Kristtiya/KittyCaddy/Pictures/Mechanical.jpg

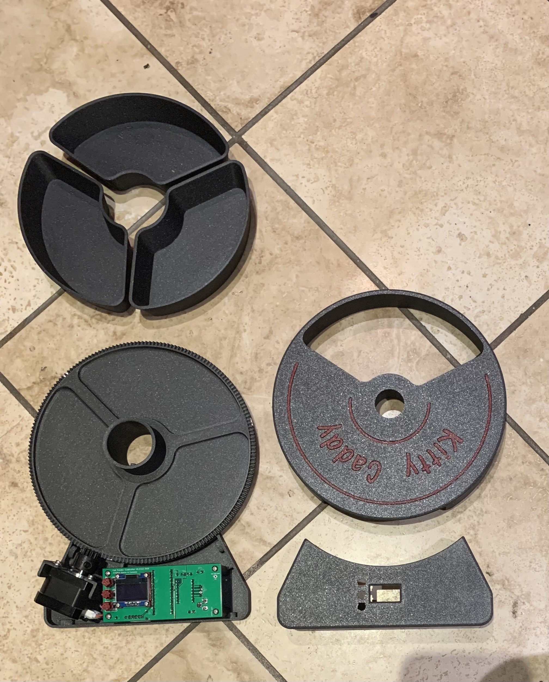
Pictures/Mechanical.jpg
