Kristtiya/KittyCaddy/Pictures/GUII2C.jpg

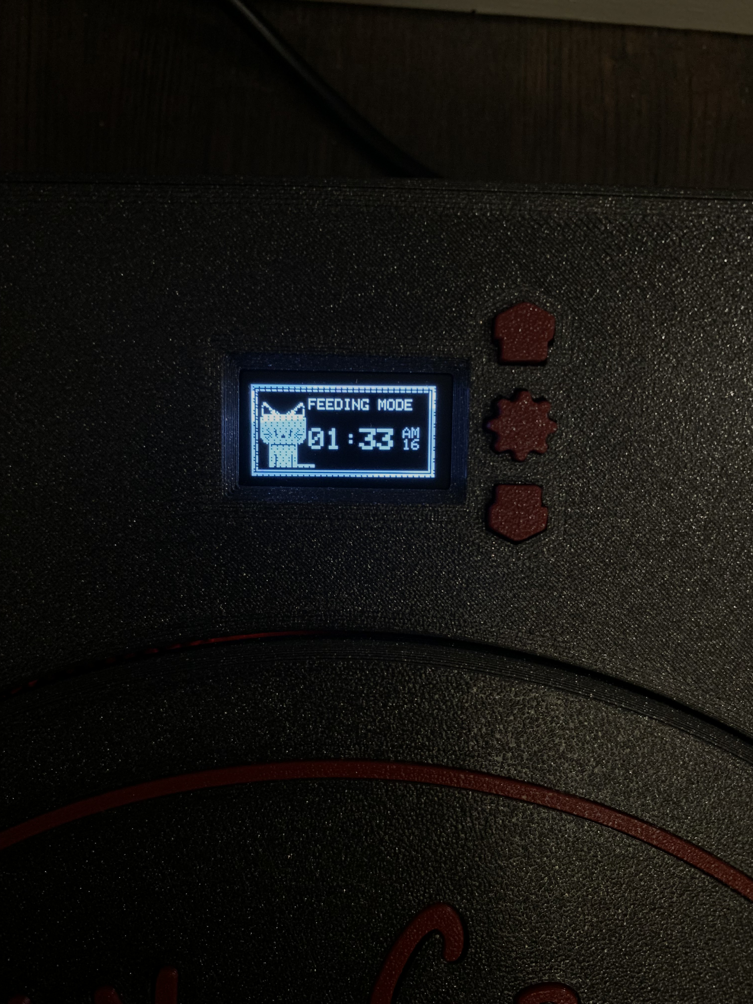
Pictures/GUII2C.jpg
