Kristtiya/KittyCaddy/Pictures/PCB Front.jpg

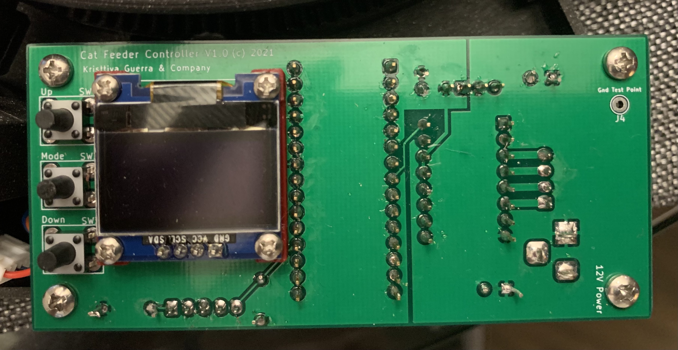
Pictures/PCB Front.jpg
