Kristtiya/KittyCaddy/Pictures/PCBwire.JPG

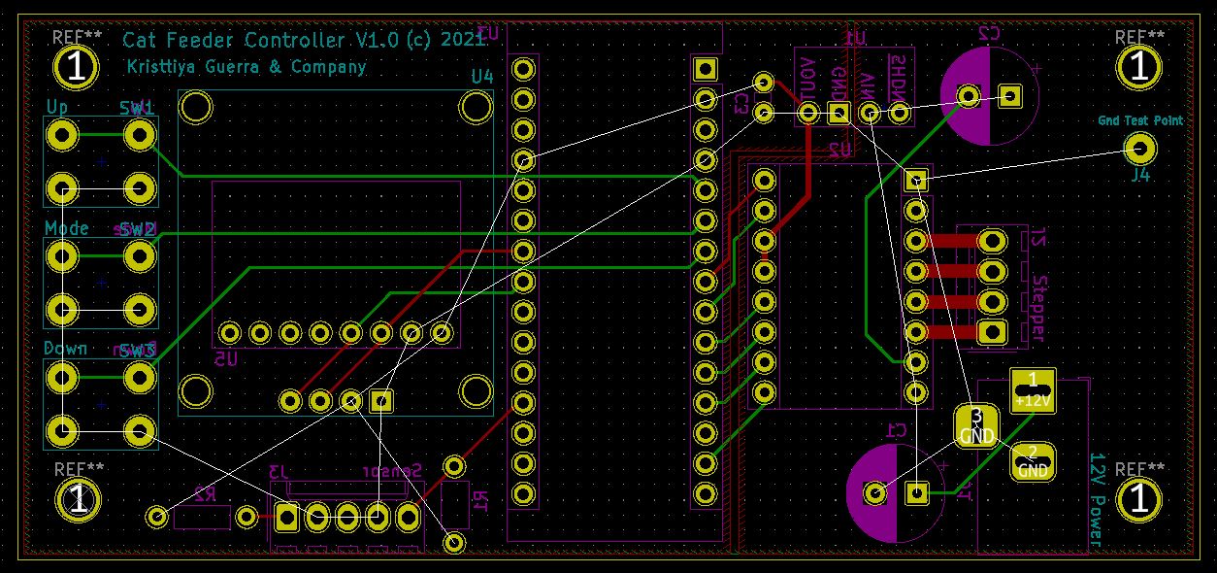
Pictures/PCBwire.JPG
