Kristtiya/KittyCaddy/Pictures/Schematic.JPG

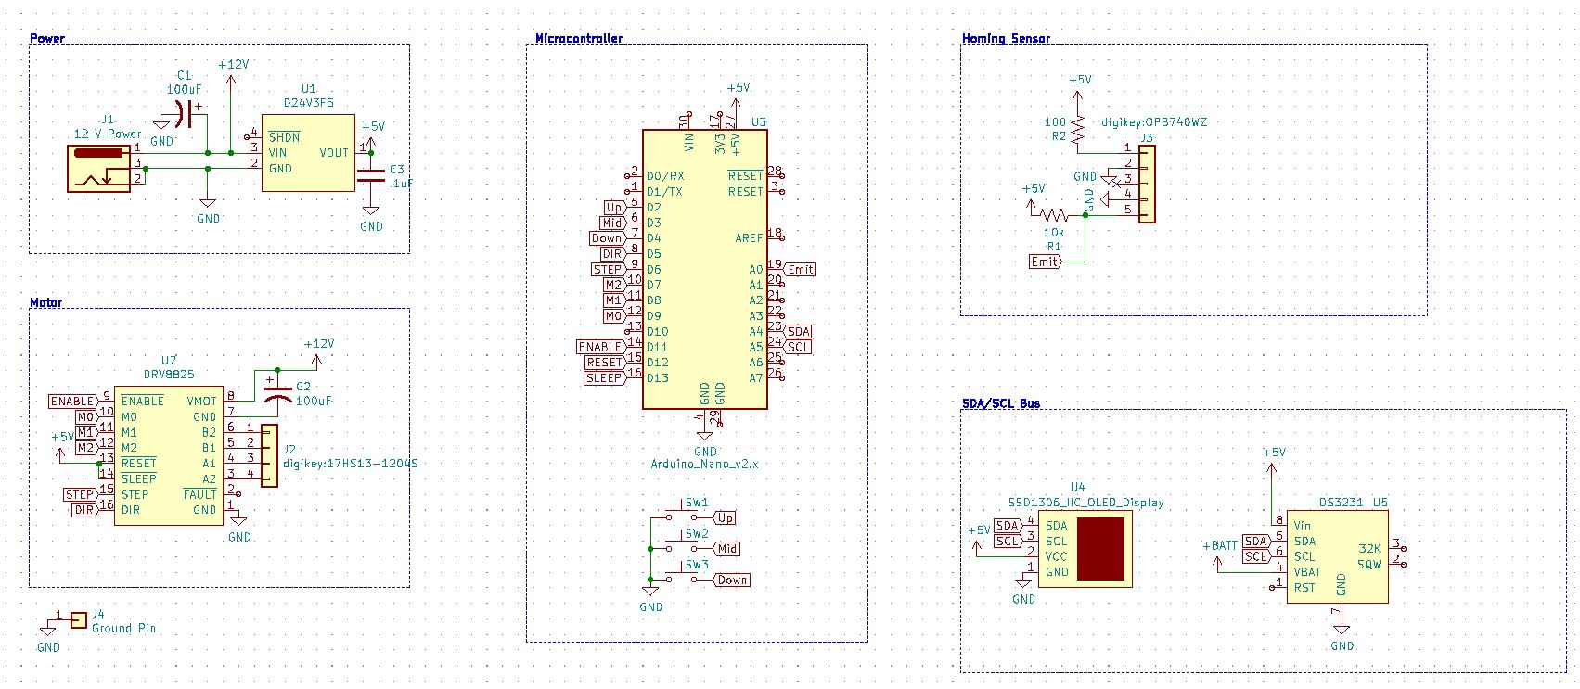
Pictures/Schematic.JPG
