Kristtiya/KittyCaddy/Schedule.xlsx

Sheet: Calendar
2021 | DECEMBER |  | MONDAY
CALENDAR YEAR | CALENDAR MONTH |  | FIRST DAY OF WEEK
44522 | 44523 | 44524 | 44525 | 44526 | 44527 | 44528
2021-11-29 | 2021-11-30 | 2021-12-01 | 2021-12-02 | 2021-12-03 | 2021-12-04 | 2021-12-05
2021-12-06 | 2021-12-07 | 2021-12-08 | 2021-12-09 | 2021-12-10 | 2021-12-11 | 2021-12-12
2021-12-13 | 2021-12-14 | 2021-12-15 | 2021-12-16 | 2021-12-17 | 2021-12-18 | 2021-12-19
2021-12-20 | 2021-12-21 | 2021-12-22 | 2021-12-23 | 2021-12-24 | 2021-12-25 | 2021-12-26
2021-12-27 | 2021-12-28 | 2021-12-29 | 2021-12-30 | 2021-12-31 | 2022-01-01 | 2022-01-02
2022-01-03 | 2022-01-04 | 2022-01-05 | 2022-01-06 | 2022-01-07 | 2022-01-08 | 2022-01-09

Sheet: October
2021 | OCTOBER |  | MONDAY
CALENDAR YEAR | CALENDAR MONTH |  | FIRST DAY OF WEEK
44522 | 44523 | 44524 | 44525 | 44526 | 44527 | 44528
2021-11-29 | 2021-11-30 | 2021-12-01 | 2021-12-02 | 2021-12-03 | 2021-12-04 | 2021-12-05
2021-12-06 | 2021-12-07 | 2021-12-08 | 2021-12-09 | 2021-12-10 | 2021-12-11 | 2021-12-12
2021-12-13 | 2021-12-14 | 2021-12-15 | 2021-12-16 | 2021-12-17 | 2021-12-18 | 2021-12-19
Finish Schematic + Footprint | Present work to Stan; Finish Footprints; Begin PCB | Work on PCB, Breadboard components | Complete PCB; begin testing components> Begin programming buttons and display since they lack external components. Goal:Get motor to rotate with buttons.
2021-12-20 | 2021-12-21 | 2021-12-22 | 2021-12-23 | 2021-12-24 | 2021-12-25 | 2021-12-26
Show breadboard and code. Show PCB and order | Goal:Connect clock to display and be able to display a time; Connect buttons to clock- toggle. Stretch goal>Select and edit time ; Continue working on understanding of motor
2021-12-27 | 2021-12-28 | 2021-12-29 | 2021-12-30 | 2021-12-31 | 2022-01-01 | 2022-01-02
Show Stan Testing Sequence; Plan out how to combine all features; Present Beepy? | Goal: Get motor to rotate with clock - 30 second interval;
2022-01-03 | 2022-01-04 | 2022-01-05 | 2022-01-06 | 2022-01-07 | 2022-01-08 | 2022-01-09

Sheet: November1
2021 | NOVEMBER |  | MONDAY
CALENDAR YEAR | CALENDAR MONTH |  | FIRST DAY OF WEEK
44522 | 44523 | 44524 | 44525 | 44526 | 44527 | 44528
2021-11-29 | 2021-11-30 | 2021-12-01 | 2021-12-02 | 2021-12-03 | 2021-12-04 | 2021-12-05
Show Stan coding progress; Present soldered PCB; Determing if necessary to make new PCB | Address PCB feedback; Continue working on Motor-clock code. Note errors and problems with code
2021-12-06 | 2021-12-07 | 2021-12-08 | 2021-12-09 | 2021-12-10 | 2021-12-11 | 2021-12-12
Present current feeder and show issues- address code problems on spot | Work on Motor-clock code. Mess around with UI.
2021-12-13 | 2021-12-14 | 2021-12-15 | 2021-12-16 | 2021-12-17 | 2021-12-18 | 2021-12-19
Present current feeder and show issues- address code problems on spot | Continue Polishing code for display; Address minor issues with cat feeder rotation; Det. Upgrade of certain components
2021-12-20 | 2021-12-21 | 2021-12-22 | 2021-12-23 | 2021-12-24 | 2021-12-25 | 2021-12-26
Show stan current feeder. Discuss upgrading certain components if neceassary | Continue Polishing code for display; Address minor issues with cat feeder rotation; Det. Upgrade of certain components
2021-12-27 | 2021-12-28 | 2021-12-29 | 2021-12-30 | 2021-12-31 | 2022-01-01 | 2022-01-02
Show stan current feeder. Discuss upgrading certain components if neceassary | Continue Polishing code for display; Address minor issues with cat feeder rotation; Det. Upgrade of certain components
2022-01-03 | 2022-01-04 | 2022-01-05 | 2022-01-06 | 2022-01-07 | 2022-01-08 | 2022-01-09

Sheet: December
2021 | DECEMBER |  | MONDAY
CALENDAR YEAR | CALENDAR MONTH |  | FIRST DAY OF WEEK
44522 | 44523 | 44524 | 44525 | 44526 | 44527 | 44528
2021-11-29 | 2021-11-30 | 2021-12-01 | 2021-12-02 | 2021-12-03 | 2021-12-04 | 2021-12-05
2021-12-06 | 2021-12-07 | 2021-12-08 | 2021-12-09 | 2021-12-10 | 2021-12-11 | 2021-12-12
2021-12-13 | 2021-12-14 | 2021-12-15 | 2021-12-16 | 2021-12-17 | 2021-12-18 | 2021-12-19
Present Final work + Portfolio + project documentaion
2021-12-20 | 2021-12-21 | 2021-12-22 | 2021-12-23 | 2021-12-24 | 2021-12-25 | 2021-12-26
2021-12-27 | 2021-12-28 | 2021-12-29 | 2021-12-30 | 2021-12-31 | 2022-01-01 | 2022-01-02
2022-01-03 | 2022-01-04 | 2022-01-05 | 2022-01-06 | 2022-01-07 | 2022-01-08 | 2022-01-09
