Kristtiya/KittyCaddy/KittyCaddy_KiCAD/Schematic.pdf

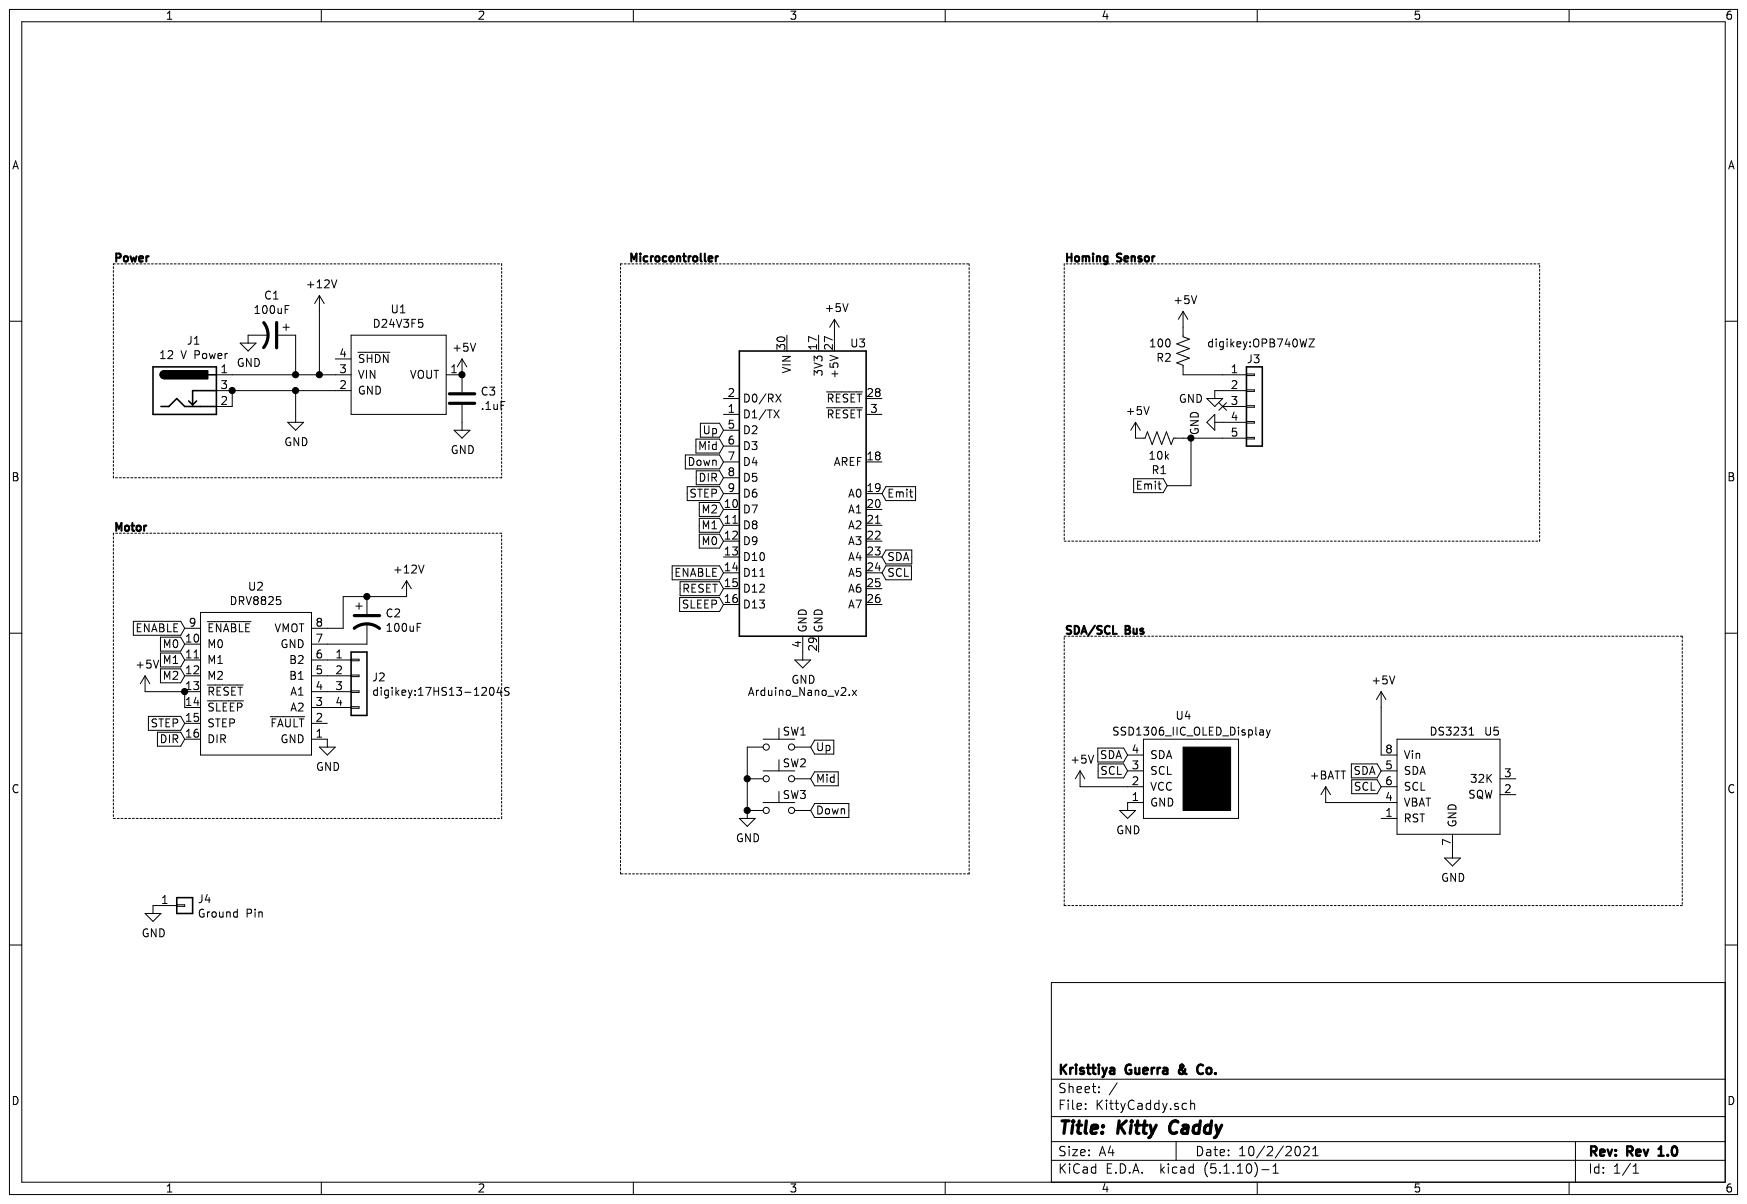
[picture p7: page 1]
