Kristtiya/KittyCaddy/KittyCaddy_KiCAD/KittyCaddy.kicad_pcb

## KiCad design KittyCaddy_KiCAD/KittyCaddy.kicad_pcb (2021-12-18)

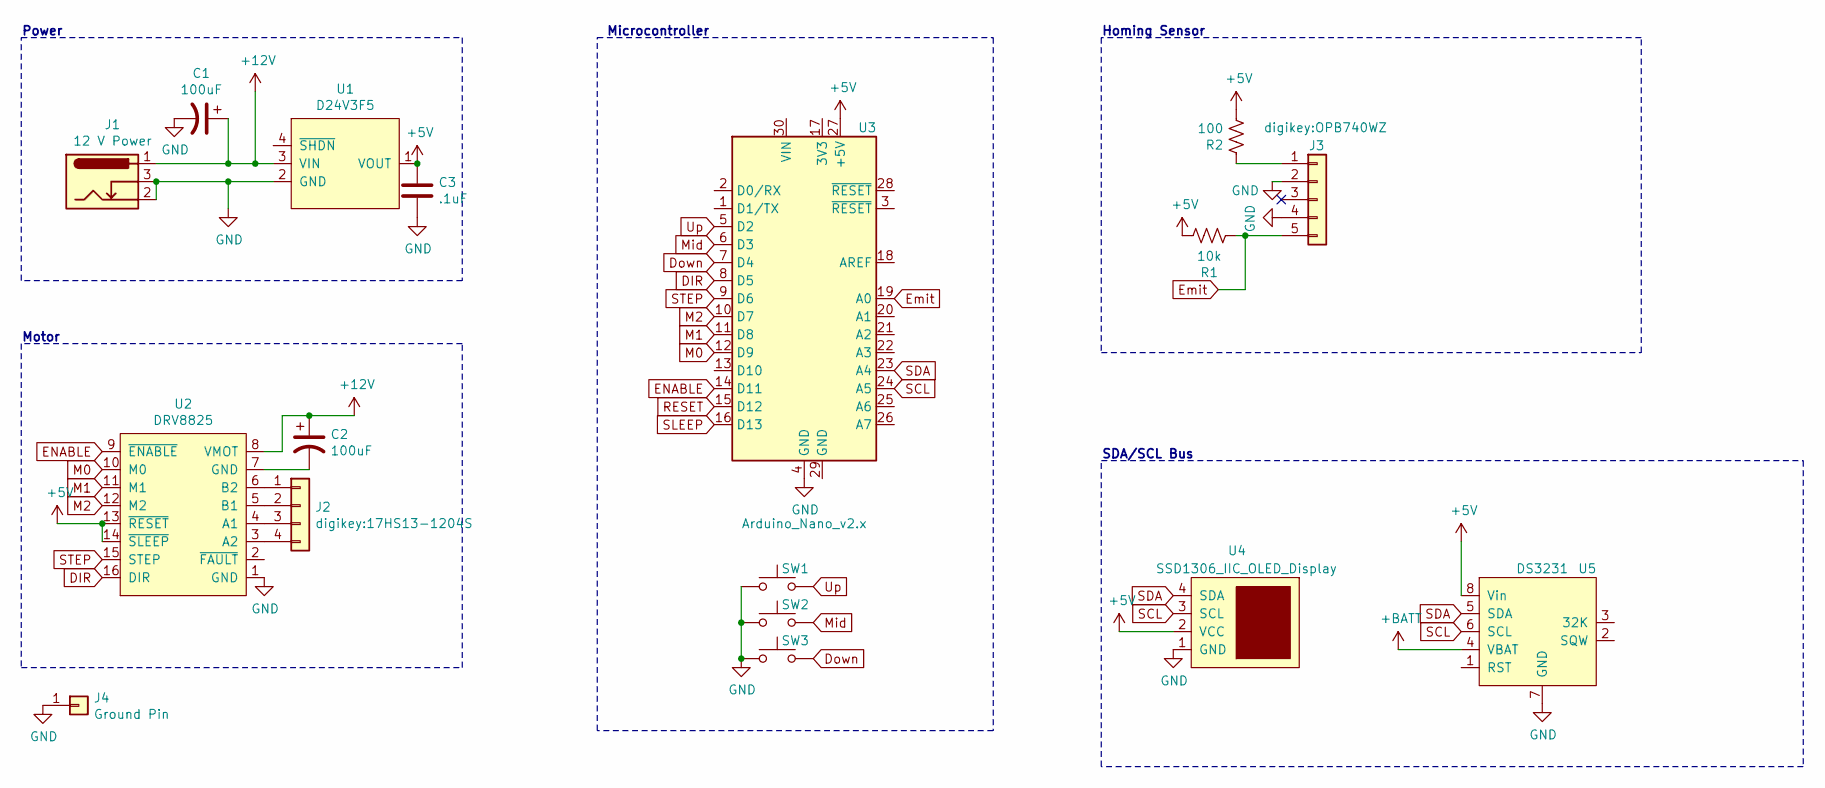
[picture p8: schematic KittyCaddy.sch, Kitty Caddy]

Parts:
C1, C2: 100uF; CP_Radial_D8.0mm_P3.50mm
C3: .1uF; 1C10Z5U104M050B
J1: 12 V Power; BarrelJack_Horizontal
J2: digikey:17HS13-1204S; Molex_KK-254_AE-6410-04A_1x04_P2.54mm_Vertical
J3: digikey:OPB740WZ; Molex_KK-254_AE-6410-05A_1x05_P2.54mm_Vertical
J4: Ground Pin; Pin_D1.0mm_L10.0mm_LooseFit
R1: 10k; CF14JT10K0
R2: 100; CFR-25JT-52-100R
SW1, SW2, SW3: SW_Push; DigikeyEG1833-ND
U1: D24V3F5
U2: DRV8825; Pololu_Breakout-16_15.2x20.3mm
U3: Arduino_Nano_v2.x; Arduino_Nano
U4: SSD1306_IIC_OLED_Display; IIC_Display
U5: DS3231

Connections:
+5V: C3.1, R1.1, R2.2, U1.1 (VOUT), U2.13 (~RESET), U2.14 (~SLEEP), U3.27 (+5V), U4.2 (VCC), U5.8 (Vin)
+12V: C1.1, C2.1, J1.1, U1.3 (VIN), U2.8 (VMOT)
+BATT: U5.4 (VBAT)
DIR: U2.16 (DIR), U3.8 (D5)
Down: SW3.2, U3.7 (D4)
ENABLE: U2.9 (~ENABLE), U3.14 (D11)
Emit: J3.5, R1.2, U3.19 (A0)
GND: C1.2, C3.2, J1.2, J1.3, J3.2, J3.4, J4.1, SW1.1, SW2.1, SW3.1, U1.2 (GND), U2.1 (GND), U3.4 (GND), U4.1 (GND), U5.7 (GND)
M0: U2.10 (M0), U3.12 (D9)
M1: U2.11 (M1), U3.11 (D8)
M2: U2.12 (M2), U3.10 (D7)
Mid: SW2.2, U3.6 (D3)
unnamed: C2.2, U2.7 (GND)
unnamed: J2.1, U2.6 (B2)
unnamed: J2.2, U2.5 (B1)
unnamed: J2.3, U2.4 (A1)
unnamed: J2.4, U2.3 (A2)
unnamed: J3.1, R2.1
RESET: U3.15 (D12)
SCL: U3.24 (A5), U4.3 (SCL), U5.6 (SCL)
SDA: U3.23 (A4), U4.4 (SDA), U5.5 (SDA)
SLEEP: U3.16 (D13)
STEP: U2.15 (STEP), U3.9 (D6)
Up: SW1.2, U3.5 (D2)

Notes on the sheet:
Power
Microcontroller
SDA/SCL Bus
Homing Sensor
Motor

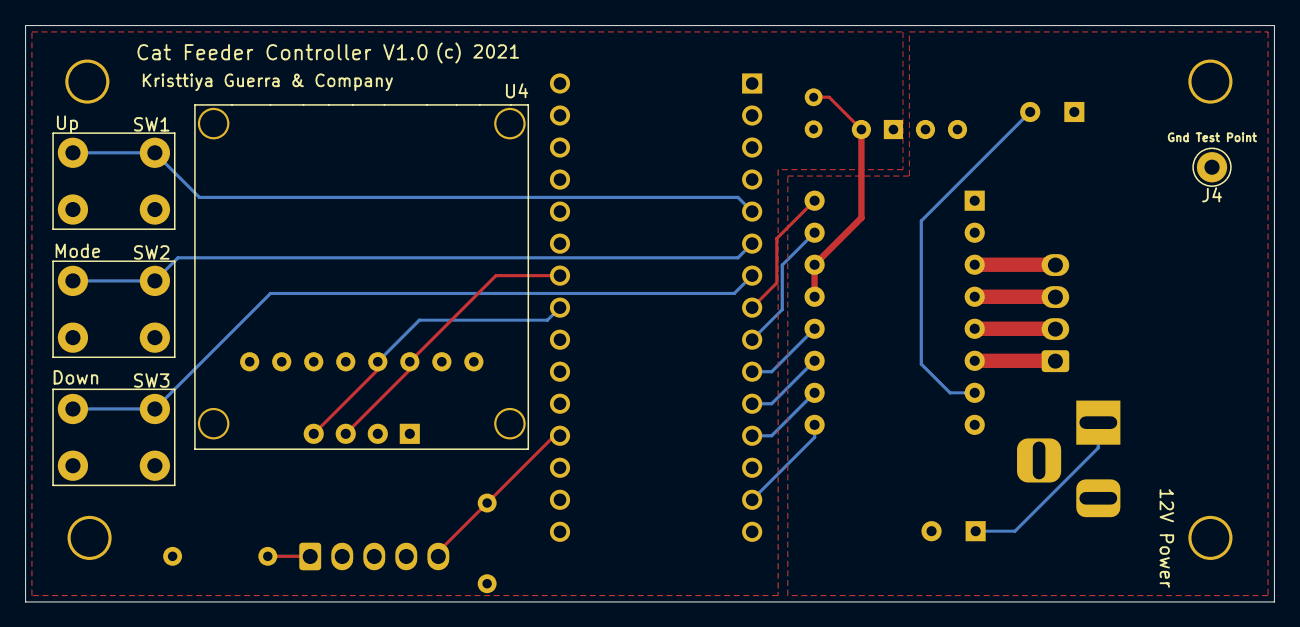
[picture p9: board KittyCaddy.kicad_pcb from above]

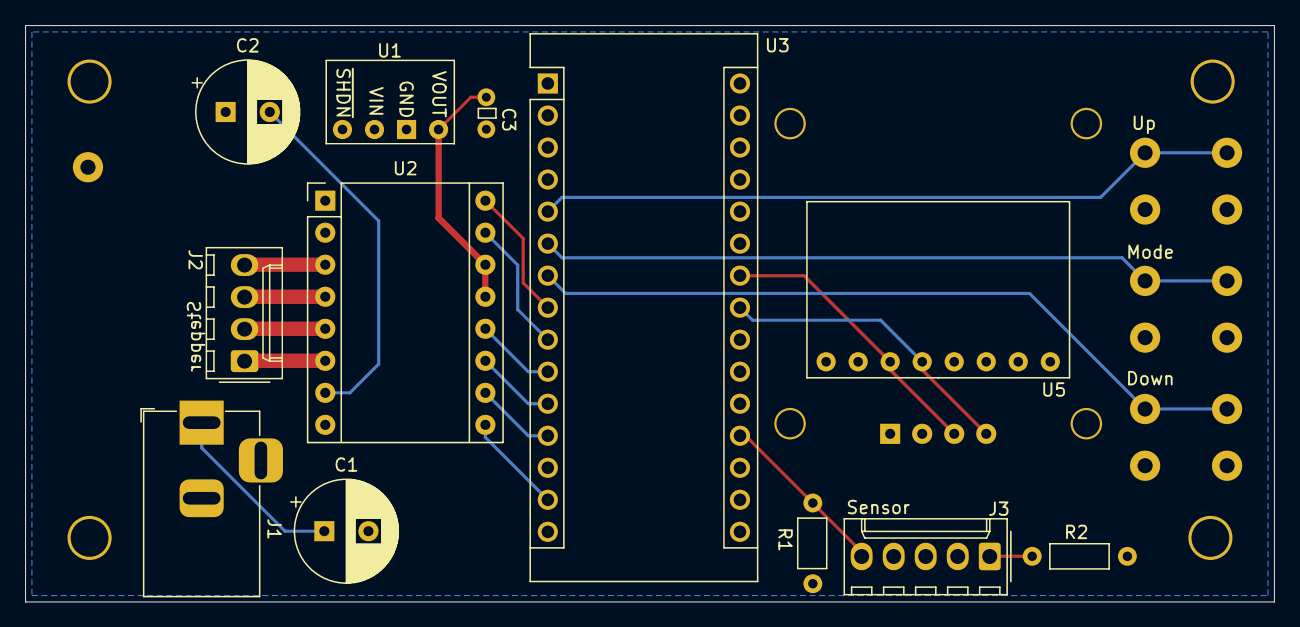
[picture p10: board KittyCaddy.kicad_pcb from below]

Board: 2 copper layers, 99.1 x 45.7 mm, 17 parts (12 on the bottom side), 21 nets.
