Kristtiya/KittyCaddy/(commit log)

2021-12-18 Upload Project
    [KittyCaddy-B_Cu.gbr, KittyCaddy-B_Mask.gbr, KittyCaddy-B_Paste.gbr, KittyCaddy-B_SilkS.gbr, KittyCaddy-Edge_Cuts.gbr, KittyCaddy-F_Cu.gbr, KittyCaddy-F_Mask.gbr, KittyCaddy-F_Paste.gbr]
2021-12-27 Update Button code: Can now determine if Menu button is held or pressed for a short duration of time.
    [BillOfMaterials.csv, KittyCaddy.csv]
2021-12-27 Fixed Menu screen: Allows selection of Feeder mode with menu button
    [CatFeederCode.ino.ino]
2021-12-30 Fixed time increment looping
    [CatFeederCode.ino.ino]
2021-12-30 Modified button function to be debouncing function
2021-12-30 Fixed enable motor function
    [CatFeederCode.ino.ino]
