Kristtiya/KittyCaddy/Pictures/CatfeederOutside.jpg

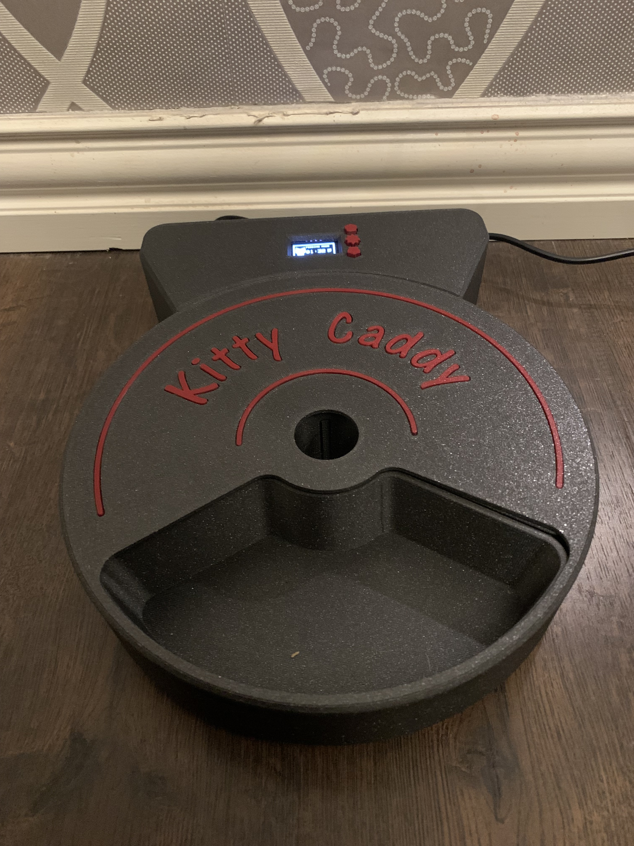
Pictures/CatfeederOutside.jpg
